manashmandal/eyedrivomatic-pure-files/grid 2 grids for eyedrivomatic pure/eye eyedrivomatic pure setup/thumbnail.jpg

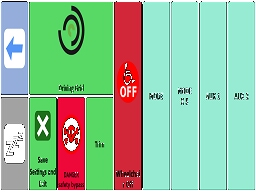
grid 2 grids for eyedrivomatic pure/eye eyedrivomatic pure setup/thumbnail.jpg
