manashmandal/eyedrivomatic-pure-files/grid 2 grids for eyedrivomatic pure/eyedrivomatic trim/thumbnail.jpg

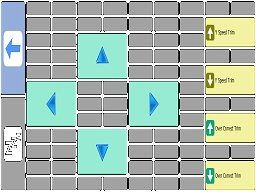
grid 2 grids for eyedrivomatic pure/eyedrivomatic trim/thumbnail.jpg
