manashmandal/eyedrivomatic-pure-files/Text Files/eyedrivomatic explained doc.docx

I can’t talk any more. I can make individual words understood, but it’s not what you would call talking. The only method I have left for controlling the computer, and what I now use for communicating, is a bluetooth wheelchair joystick, which works wirelessly as a mouse. This method soon will no longer work as MND/ALS is weakening my hand relentlessly to the point of uselessness.

I live in the UK, and our wonderful NHS has provided me with an electric wheelchair and, for when my hand does become useless, a wheelchair mounted minicomputer with an eyegaze camera. But the NHS does not allow you to control the one with the other. Control a wheelchair with your eyes - far too dangerous! Much better that you just sit where you are sir, much safer. Once you have only your eyes left they expect you to rely on your carer to move your wheelchair. If your carer is not available you stay where you are left. My MND/ALS has a slow progression rate, so when I reach that point I will remain like it for two or three years. Two or three years without being able to move, it makes me shiver with horror just to think about it.
I want to be in charge of my own life and remain as independent as possible for as long as possible, right until the end. And I am not alone. There are a multitude in my position and many more in a worse one.
It would be possible to control the wheelchair straight from the computer, to interface them directly. But I don't own either unit, and they won’t be pleased if I cut them up. Also, a solution like that would work for me but wouldn't work for anyone else. So I have designed a bolt on, one size fits all system that the mini computer can talk to via infrared, and which would then physically move the joystick on the wheelchair.
I have a piece of software on my minicomputer called grid 2. It is primarily communication software but it also does infra red environmental control. This is intended for controlling your telly and things like that by emulating a remote control. Grid2 is s a really good package because it allows the user to easily configure new pages for doing different jobs. Like, in this case driving my wheelchair with my eyes.

I built a prototype with a cardboard case and some parts kindly 3d printed by a follower from my facebook page. This allowed me to test it and prove the concept. I printed a prototype case for brains of the thing and one for the IR unit. The system is complete and works, it can easily be put together without soldering by anyone, even an idiot, for less than £70, which is about one hundred of your American dollars. My idea is to make it open source, put the plans, software and instructions on the internet for anybody to use. There are thousands of people who would benefit from this, thousands of people who are stuck in the same place, immobile unless their carers move them.
The prototype works but it’s not ready to distribute. The working parts need to be redone as does the case. The firmware needs rewriting and when that’s done I need to build two or three units for real world testing.
