manashmandal/eyedrivomatic-pure-files/Eyedrivomatic Photos/mk2 brain box case design.jpg

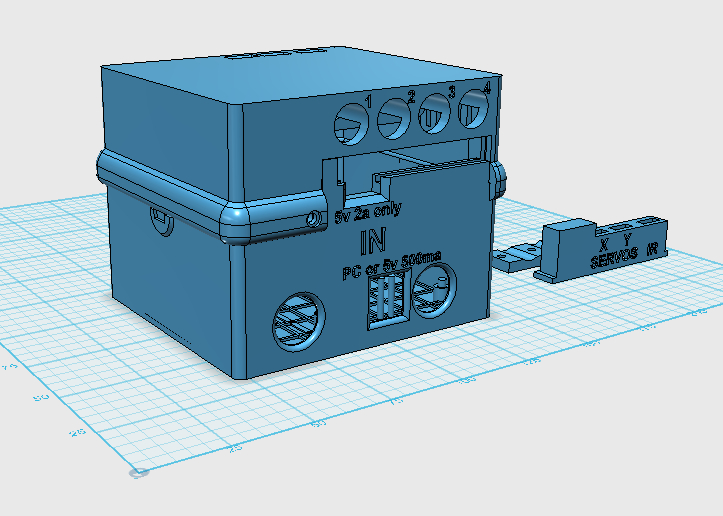
Eyedrivomatic Photos/mk2 brain box case design.jpg
