manashmandal/eyedrivomatic-pure-files/Eyedrivomatic Photos/mk2 electronic hand design.jpg

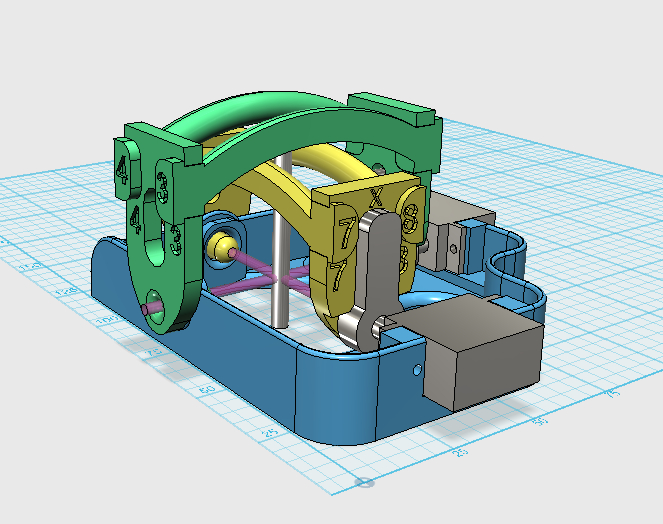
Eyedrivomatic Photos/mk2 electronic hand design.jpg
