manashmandal/eyedrivomatic-pure-files/Eyedrivomatic Photos/Mk2 Eyedrivomatic system  (1).JPG

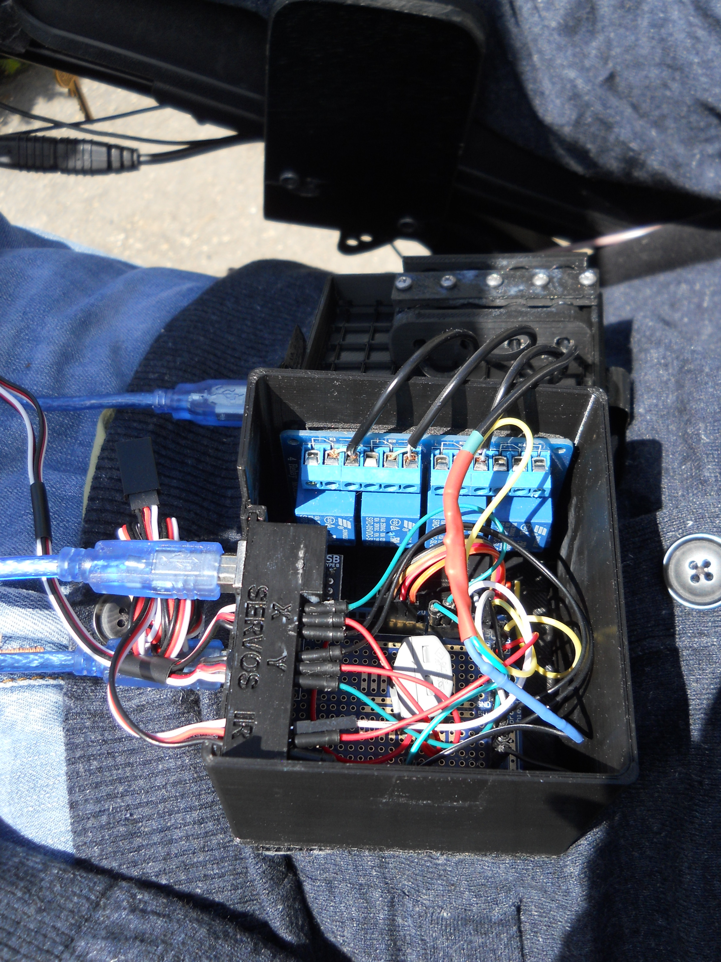
Eyedrivomatic Photos/Mk2 Eyedrivomatic system (1).JPG
