manashmandal/eyedrivomatic-pure-files/Eyedrivomatic Photos/Mk2 Eyedrivomatic system  (2).JPG

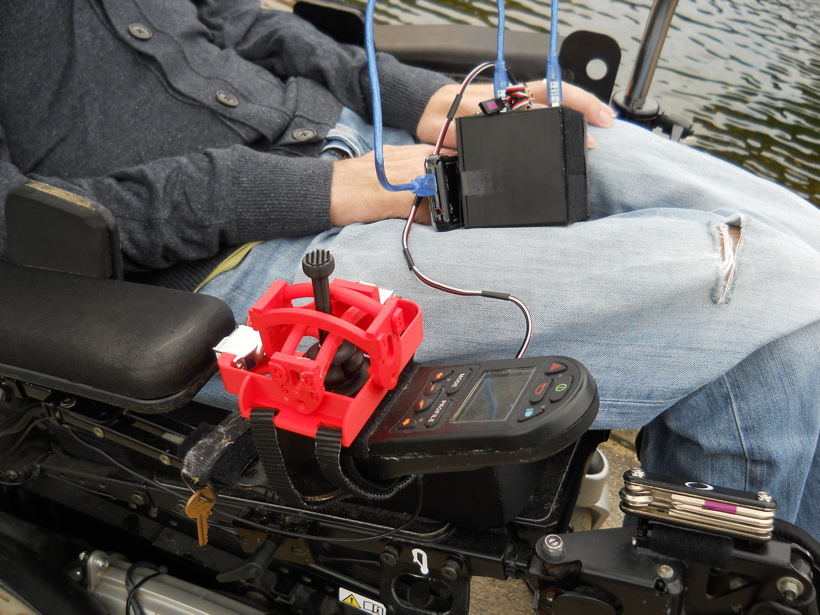
Eyedrivomatic Photos/Mk2 Eyedrivomatic system (2).JPG
