manashmandal/eyedrivomatic-pure-files/Eyedrivomatic Photos/Mk2 Eyedrivomatic system  (3).JPG

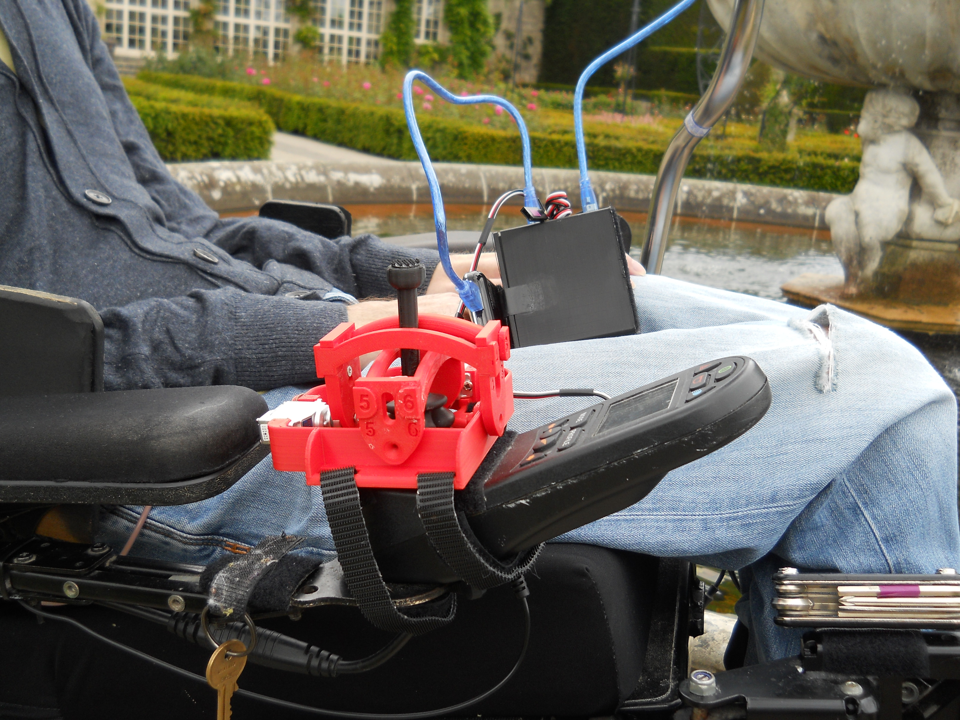
Eyedrivomatic Photos/Mk2 Eyedrivomatic system (3).JPG
