manashmandal/eyedrivomatic-pure-files/Eyedrivomatic Photos/Mk2 Eyedrivomatic system  (4).JPG

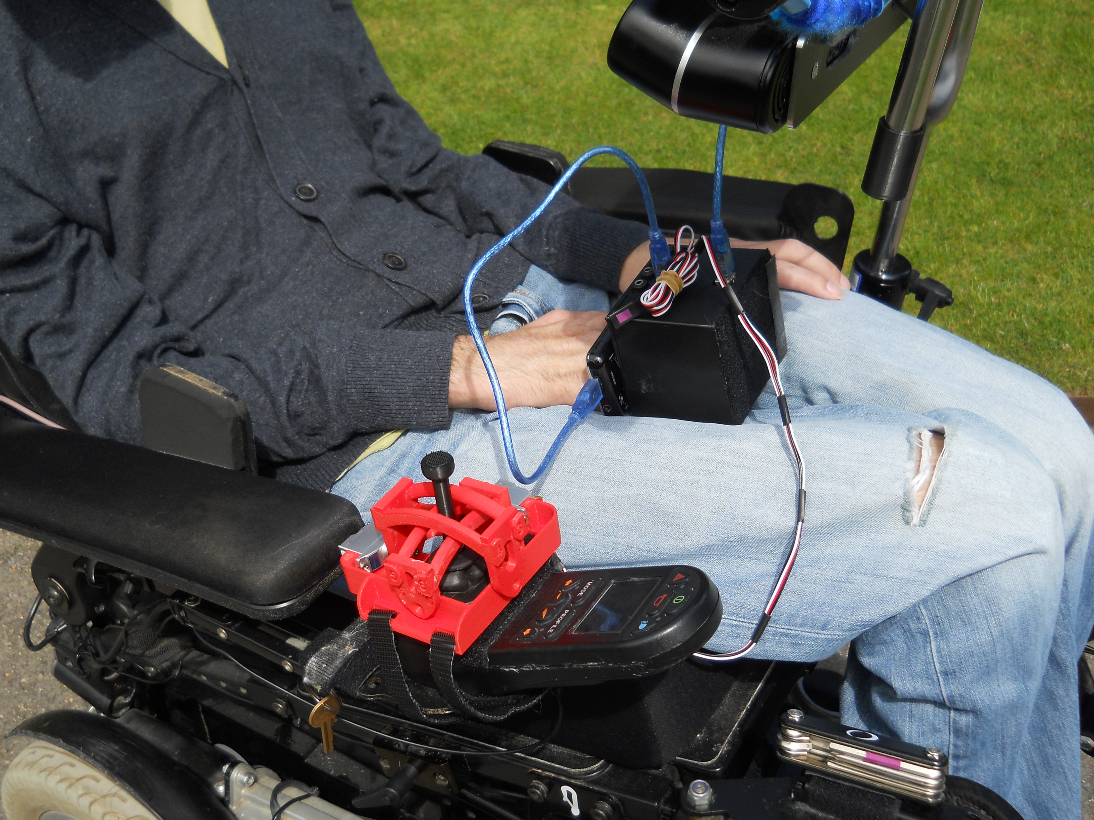
Eyedrivomatic Photos/Mk2 Eyedrivomatic system (4).JPG
