manashmandal/eyedrivomatic-pure-files/Eyedrivomatic Photos/Mk2 Eyedrivomatic system  (6).JPG

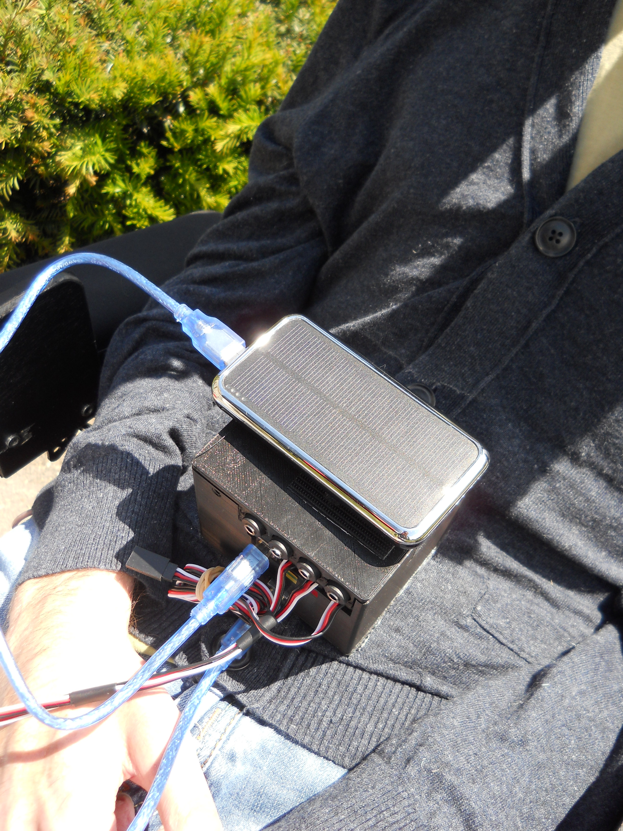
Eyedrivomatic Photos/Mk2 Eyedrivomatic system (6).JPG
