manashmandal/eyedrivomatic-pure-files/Eyedrivomatic Photos/Mk2 Eyedrivomatic system  (7).JPG

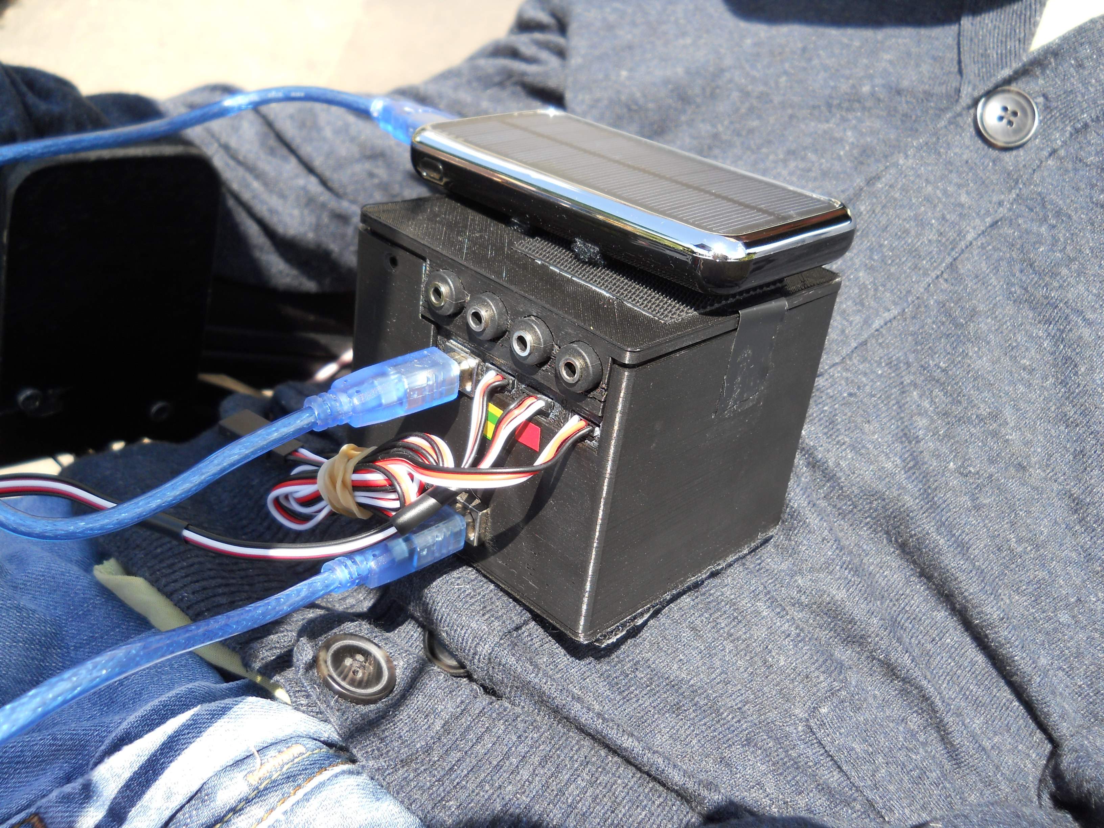
Eyedrivomatic Photos/Mk2 Eyedrivomatic system (7).JPG
