manashmandal/eyedrivomatic-pure-files/Eyedrivomatic Photos/Web quality photos/eyedrivomatic cover pic small.png

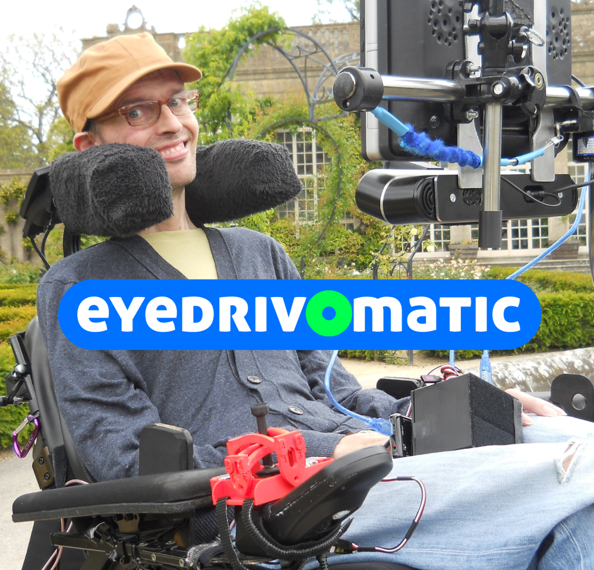
Eyedrivomatic Photos/Web quality photos/eyedrivomatic cover pic small.png
