manashmandal/eyedrivomatic-pure-files/grid 2 grids for eyedrivomatic pure/eye eyedrivomatic pure/thumbnail.jpg

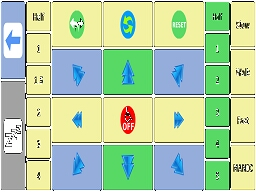
grid 2 grids for eyedrivomatic pure/eye eyedrivomatic pure/thumbnail.jpg
