manashmandal/eyedrivomatic-pure-files/Text Files/eyedrivomatic components list.odt

Turnigy 380 max micro servo

or similar high torque micro servo

£15

Arduino uno R3

£6 - £17

4 relay module (5v)

£3.50

3.5mm sockets (mono)

£2 each

Dupont cables

20cm long, male to female ends

£2

Self tapping screws

no.6 (3.5mm) 13mm long, 12 pieces

£1

Super glue

£1

Double sided foam tape

£2.50
