manashmandal/eyedrivomatic-pure-files/stl files/mk1_evans_locator.stl

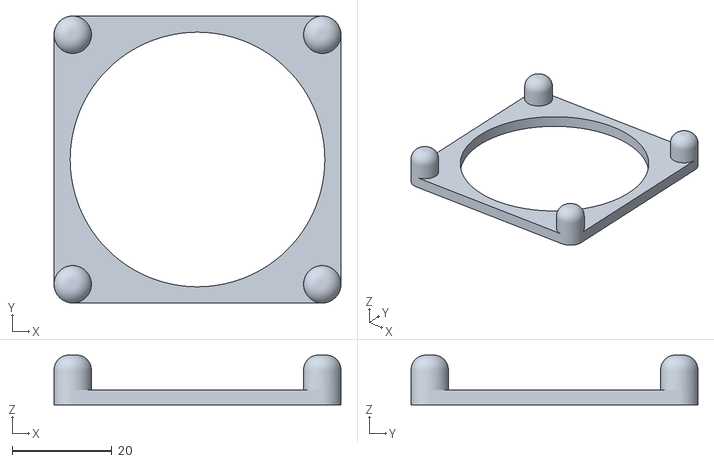
[picture p30: CAD file, 2015-08-01]
stl files/mk1_evans_locator.stl
57.5 x 57.5 x 10.0
