manashmandal/eyedrivomatic-pure-files/stl files/eyedrivomatic_brain_box_lid.stl

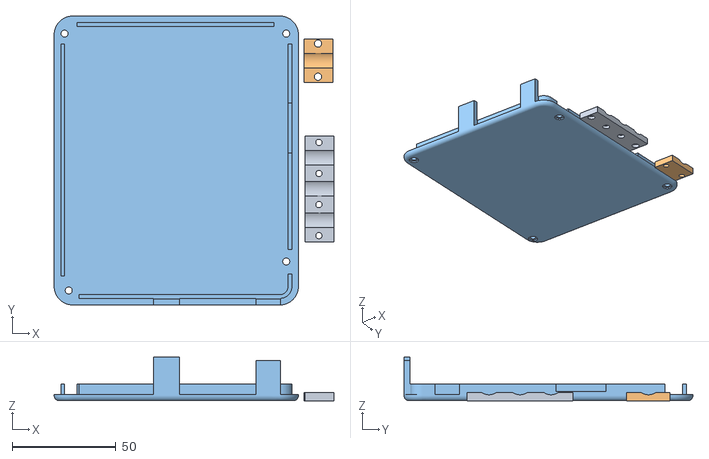
[picture p31: CAD file, 2015-08-01]
stl files/eyedrivomatic_brain_box_lid.stl
135.0 x 139.5 x 21.0
