manashmandal/eyedrivomatic-pure-files/Text Files/mk3 brain box wiring list.odt

Mk3 brain box wiring list

Strip the ends of the four wires coming from the 3.5mm sockets (each cable will have two wires inside it). Connect each pair of stripped wires to one of the four relay outputs, one wire to the common (middle hole), and one to the normally open side

Join together 3 wires (red ideally) so you have one female end and two male. The others can be 10cm long. Join these to the red wire from the led near the lone usb socket. The female end goes to vcc on the lone usb socket. The two male ends go to the middle holes on the x and y servo plugs, opposite the red wire on the outside of the box.

then join together 5 wires (black ideally) so you have 2 female ends and 3 male. One of the females and one of the males need to be a bit longer, say 14cm long. Join these to the black wires from both the led near the lone usb socket , and the led near the arduino. One of the female ends goes to gnd on the lone usb socket. The other female end goes to the gnd pin on the relay module. One of the male ends goes to gnd on the arduino. The other two go to the x and y plugs. On the outside of the box, there are three wires going in to the plugs. Each plug will have a wire going in to it that is black or brown. The two male ends go to the holes opposite the black or brown wire on the outside.

then join two red wires (one male, one female) to the red wire from the led near the arduino. These will go to the 5v pin on the arduino and the vcc pin on the relay module.

relay module pins

pin 1 to 9 arduino

pin 2 to 10 arduino

pin 3 to 11 arduino

pin 4 to 12 arduino

the two servo plugs, named x and y

x plug

You have already done the red and black wires on this plug. Put a male wire of any colour (apart from red or black) in the hole opposite the white or yellow wire on the outside of the box. Then put the other end of the wire to pin 6 on the arduino.

y plug

You have already done the red and black wires on this plug. Put a male wire of any colour (apart from red or black) in the hole opposite the white or yellow wire on the outside of the box. Then put the other end of the wire to pin 7 on the arduino.

Mk3 brain box wiring list

my one. The two brain boxes are different. My one has the red and black sockets.

strip the ends of the three wires coming from the red 3.5mm sockets (each cable will have two wires inside it). Ignore the black socket (it is the socket of dooom). Connect each pair of stripped wires to one of the four relay outputs, one wire to the common (middle hole), and one to the normally open side

Join together 5 wires (red ideally) so you have one female end and 4 male. Join these to the red wire from the led near the lone usb socket. The female end goes to vcc on the lone usb socket. Two of the male ends go to the middle holes on the x and y servo plugs, opposite the red wire on the outside of the box.

then join together 7 wires (black ideally) so you have 2 female ends and 5 male . Join these to the black wires from both the led near the lone usb socket , and the led near the arduino. One of the female ends goes to gnd on the lone usb socket. The other female end goes to the gnd pin on the relay module. One of the male ends goes to gnd on the arduino. Two more go to the x and y plugs. On the outside of the box, there are three wires going in to the plugs. Each plug will have a wire going in to it that is black or brown. The two male ends go to the holes opposite the black or brown wire on the outside.

then join two red wires (one male, one female) to the red wire from the led near the arduino. These will go to the 5v pin on the arduino and the vcc pin on the relay module.

relay module pins

pin 1 to 9 arduino

pin 2 to 10 arduino

pin 3 to 11 arduino

pin 4 to 12 arduino

the two servo plugs, named x and y

x plug

You have already done the red and black wires on this plug. Put a male wire of any colour (apart from red or black) in the hole opposite the white or yellow wire on the outside of the box. Then put the other end of the wire to pin 6 on the arduino.

y plug

You have already done the red and black wires on this plug. Put a male wire of any colour (apart from red or black) in the hole opposite the white or yellow wire on the outside of the box. Then put the other end of the wire to pin 7 on the arduino.
