manashmandal/eyedrivomatic-pure-files/(notices)

Notices in the files:
Software/eyedrivomatic_pure_arduino_firmware/eyedrivomatic_pure_arduino_firmware.ino:
This program is free software: you can redistribute it and/or modify
it under the terms of the GNU General Public License version 3
